Fatmire09/Smart-Greenhouse-Controller/images/photo2.jpeg

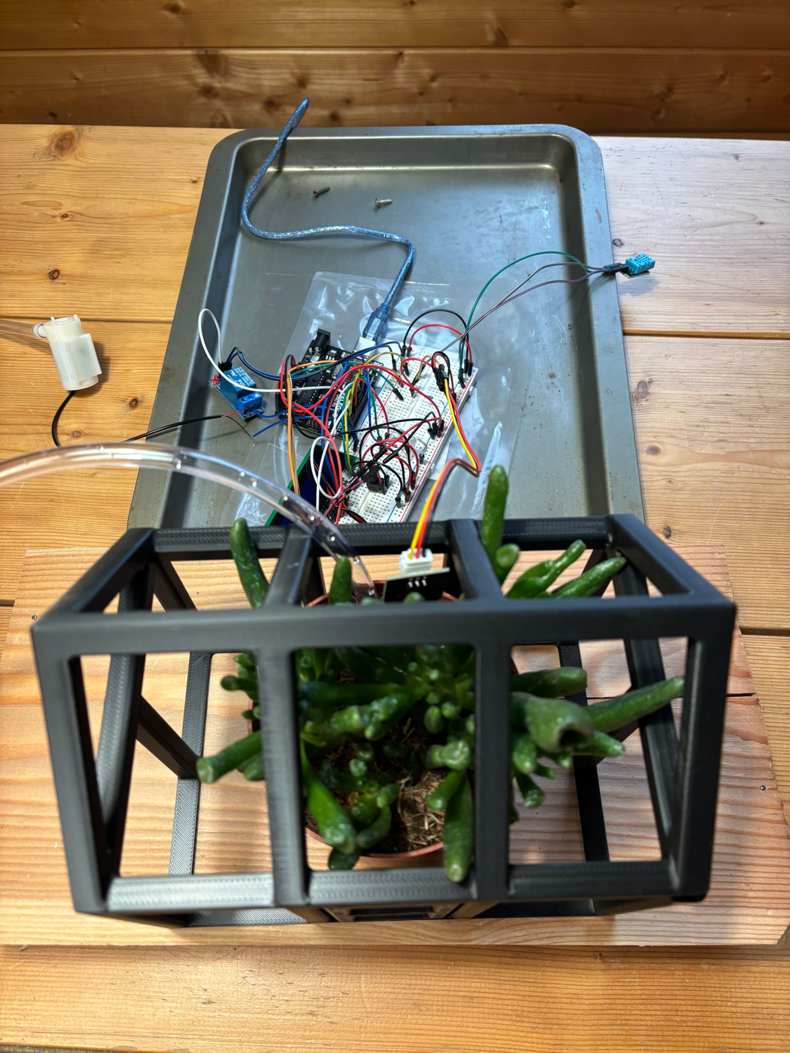
images/photo2.jpeg
