Fatmire09/Smart-Greenhouse-Controller/images/photo1.jpeg

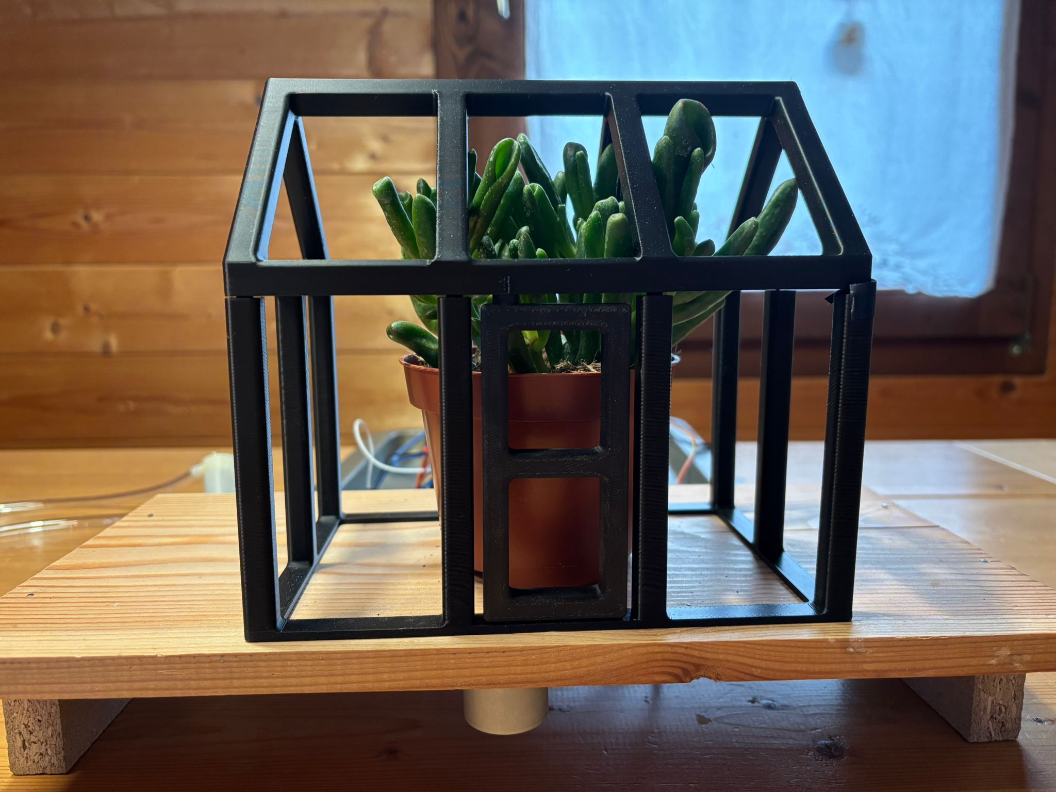
images/photo1.jpeg
