Fatmire09/Smart-Greenhouse-Controller/docs/Smart_Greenhouse_presentation.pdf

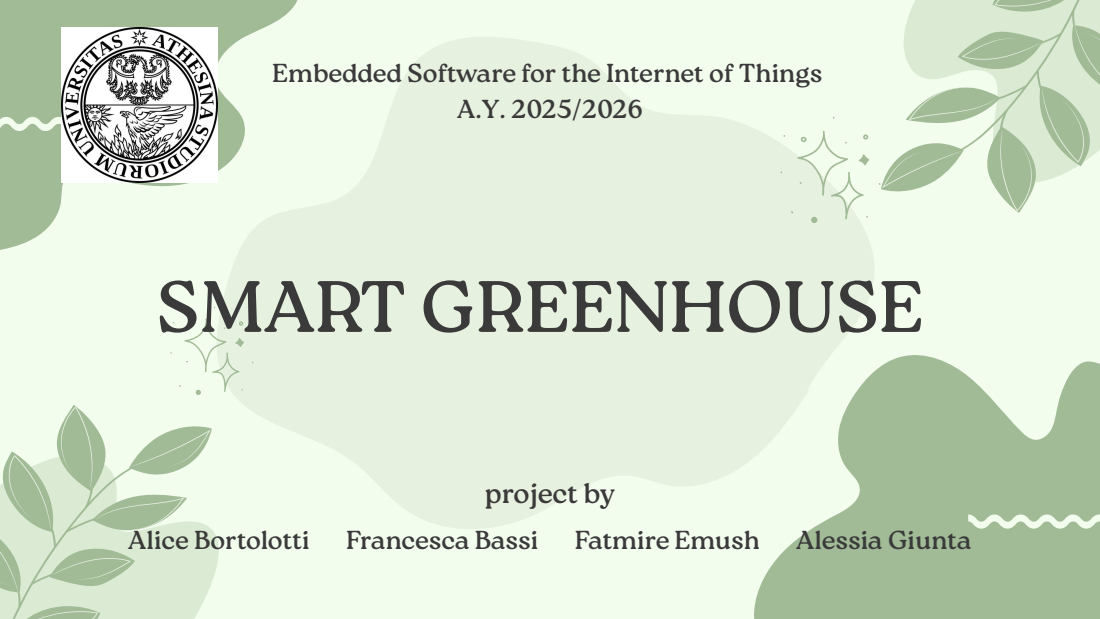
[picture p10: page 1]
project by; SMART GREENHOUSE

Embedded Software for the Internet of Things

Alice Bortolotti Francesca Bassi Fatmire Emush Alessia Giunta

| | Project Aim

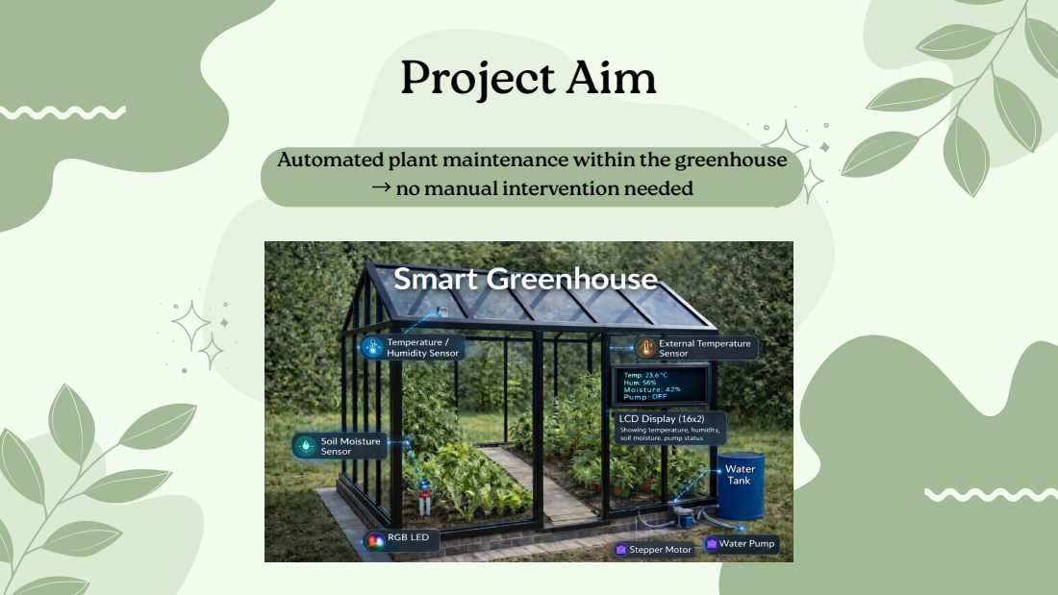
[picture p11: page 2]

Automated plant maintenance within the greenhouse | → no manual intervention needed

# Software Architecture

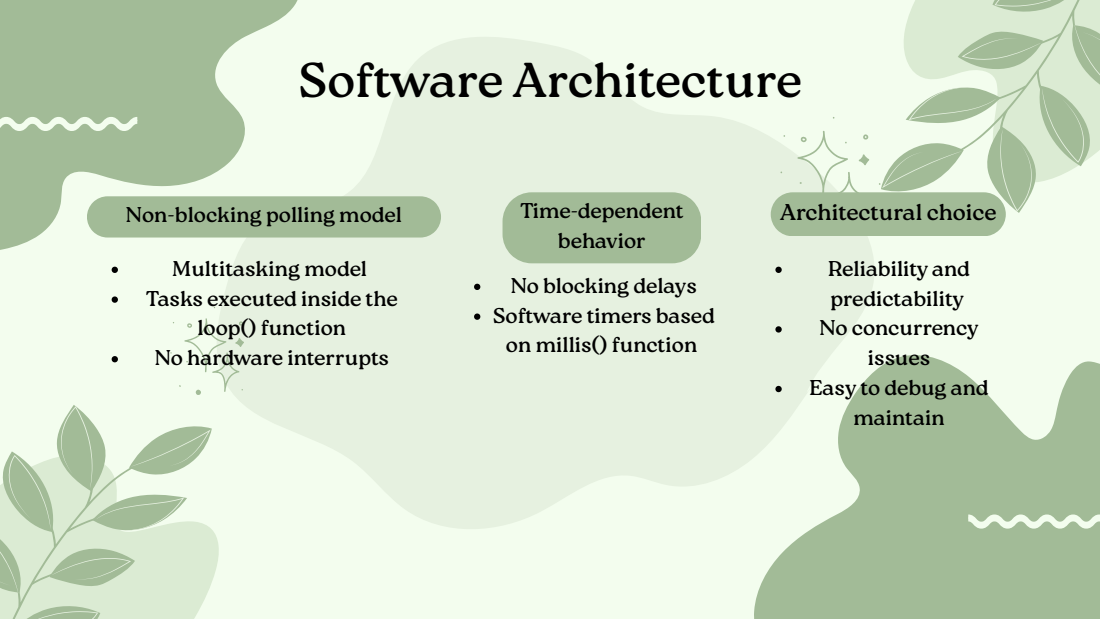
[picture p12: page 3]
Non-blocking polling model; Time-dependent

Multitasking model
Tasks executed inside the
loop() function
No hardware interrupts

Architectural choice
Reliability and
predictability
No concurrency
issues
Easy to debug and
maintain

behavior
No blocking delays
Software timers based
on millis() function

# Representative Code

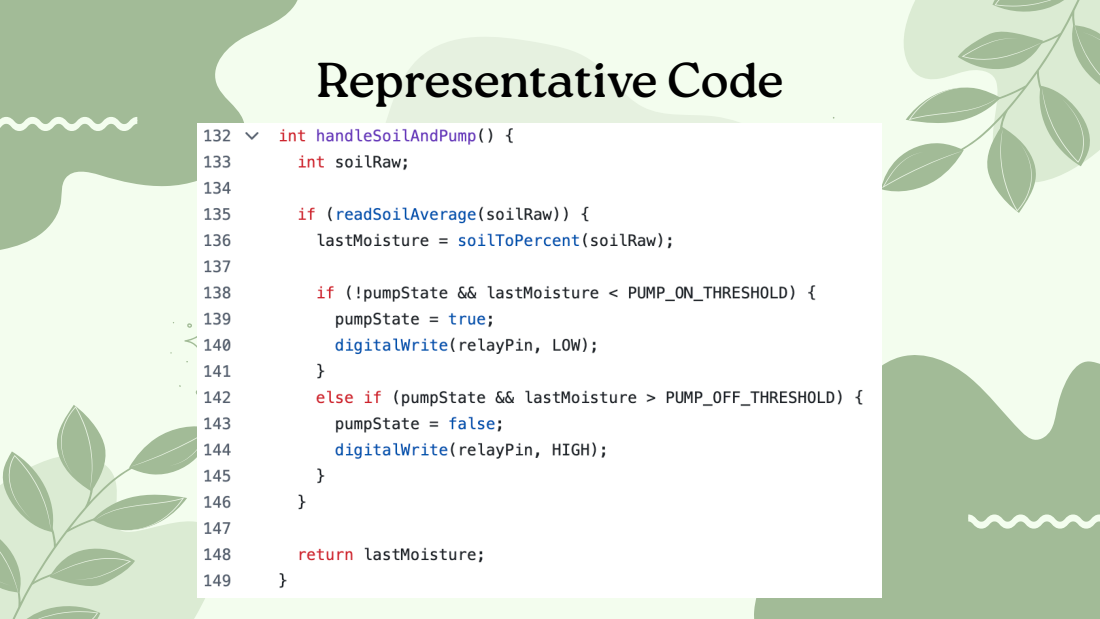
[picture p13: page 4]

# Testing and problems

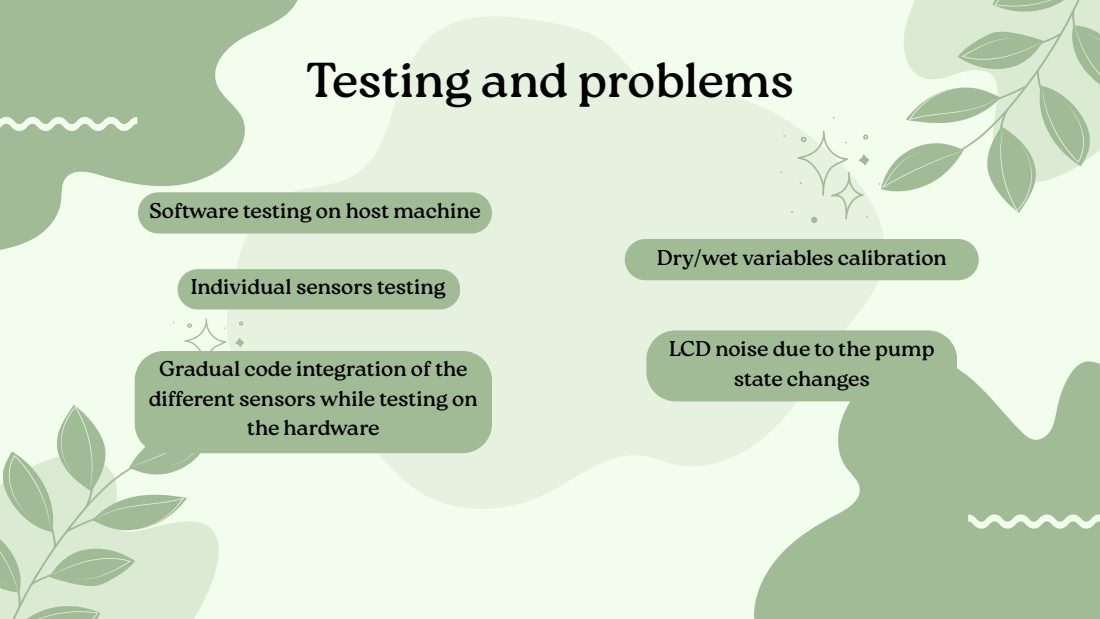
[picture p14: page 5]
the hardware

Software testing on host machine

Dry/wet variables calibration

Individual sensors testing

LCD noise due to the pump
state changes

Gradual code integration of the
different sensors while testing on

# Possible improvements

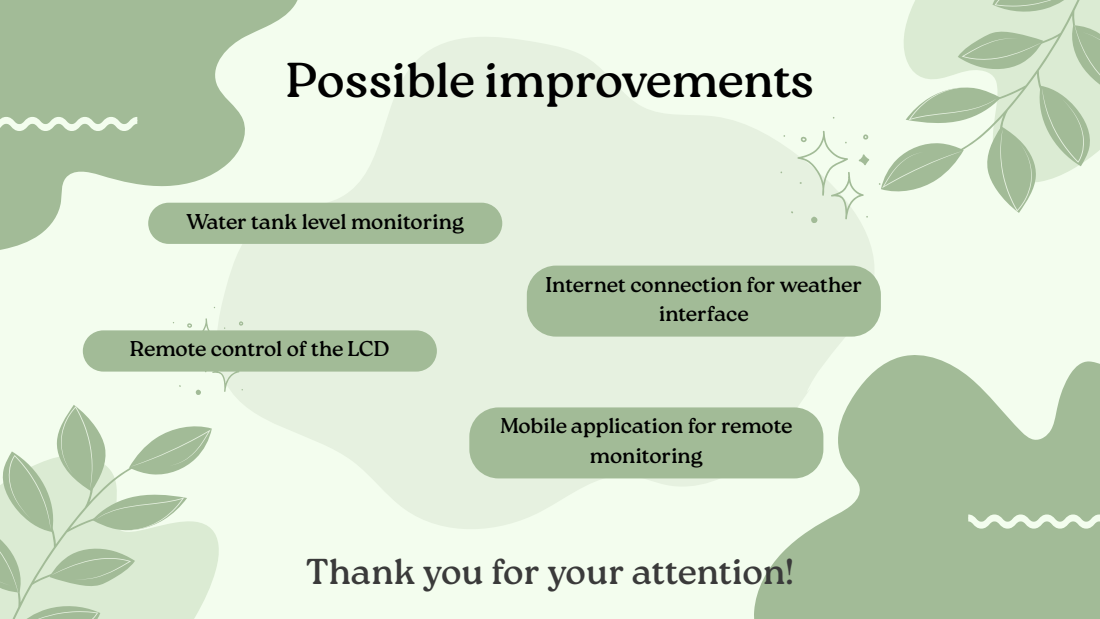
[picture p15: page 6]
interface

Water tank level monitoring

Internet connection for weather

Remote control of the LCD

Mobile application for remote
monitoring

Thank you for your attention!
