Fatmire09/Smart-Greenhouse-Controller/images/wiring_diagram.png

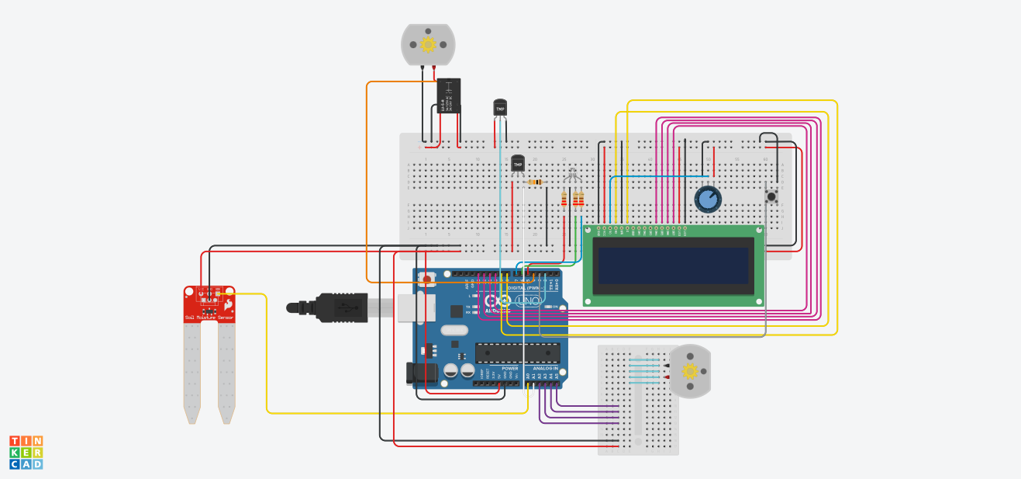
images/wiring_diagram.png
